hafizuddinus/Tx-and-Rx-Board-W-Estop/README.md

link schematic and layout of tx and rx board:
- tx schematic    : https://kicanvas.org/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
- rx layout       : https://kicanvas.org/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
- rx schematic    : https://kicanvas.org/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
- rx layout       : https://kicanvas.org/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
