hafizuddinus/Tx-and-Rx-Board-W-Estop/fmea-sil2-pld.md

# Analisis FMEA Komprehensif Master dan Evaluasi SIL 2 / PL d Sistem Wireless E-Stop

## 1. Arsitektur Keselamatan End-to-End dan Deskripsi Fungsi Sistem

Sistem *Wireless Emergency Stop* (Wireless E-Stop) ini dirancang untuk memenuhi standar keselamatan fungsional industri tertinggi, yaitu **ISO 13849-1 Category 3 / Performance Level d (PL d)** dan **IEC 62061 / IEC 61508 Safety Integrity Level 2 (SIL 2)**. Sistem ini bertugas memutus jalur daya utama $24\text{V DC}$ ke aktuator/mesin secara aman, andal, dan deterministik dalam waktu tanggap (*response time*) kurang dari $60\text{ ms}$ ketika tombol *Emergency Stop* (E-Stop) ditekan, terjadi gangguan transmisi nirkabel, atau terdeteksi kegagalan komponen internal.

Arsitektur keselamatan terdistribusi ini dibagi menjadi tiga blok utama yang saling mengevaluasi secara silang (*cross-monitoring*):

```
┌───────────────────────────────────────────────────────────────────────────────┐
│                          SUBSISTEM INPUT TRANSMITTER (TX)                     │
│  - DPDT Switch Input (J4): Antivalent Signaling (1,0 vs 0,1)                  │
│  - Hardware Logic Evaluator: 74HC86 (XOR) + 74HC14 (INV) + 74HC08 (AND)       │
│  - Visual Indicator Driver: Transistor BC550 (Q1-Q3) + LED (D6-D8)            │
│  - Battery ADC Monitoring: Resistor Divider R13/R14 + ESP32-S3 (U2 IO7)       │
└──────────────────────────────────────┬────────────────────────────────────────┘
                                       │ Transmisi Nirkabel nRF24L01 (U6 -> U3)
                                       │ Payload: Heartbeat 12ms, CRC16, ID
┌──────────────────────────────────────▼────────────────────────────────────────┐
│                       SUBSISTEM KOMUNIKASI BLACK CHANNEL                      │
│  - Modul Transceiver nRF24L01 (TX U6 / RX U3) SPI Interface                   │
│  - Checksum Integrity: CRC16 Error Detection                                  │
│  - Watchdog Timeout Handler: MCU RX Cutoff jika T > 60 ms (< 5 Packet Loss)   │
└──────────────────────────────────────┬────────────────────────────────────────┘
                                       │ command1, command2 (MCU RX U2 IO4/IO5)
┌──────────────────────────────────────▼────────────────────────────────────────┐
│                      SUBSISTEM HARDWARE INTERLOCK LOGIC (RX)                  │
│  - Dual XOR Gate (U4A/B): Pembanding Mismatch (command vs feedback)           │
│  - RC Blanking Time Filter (R5/C10/D5 & R8/C12/D7): Penyerap delay transien   │
│  - Schmitt Trigger Inverter (U5): Pengondisi sinyal trigger fault             │
│  - Hardware SR-Latch (U6/U7): Pengunci fisik trip hingga di-reset manual      │
│  - Reset Manual Button (SW3 / sw-set): Pengaktif ulang kuncian Latch          │
└──────────────────────────────────────┬────────────────────────────────────────┘
                                       │ Trigger Ch1, Trigger Ch2
┌──────────────────────────────────────▼────────────────────────────────────────┐
│                   SUBSISTEM AKTUATOR PEMUTUS SERI & FEEDBACK                   │
│  - Dual PhotoMOS Seri (U8 & U9 / AQY282S): Pemutus fisik daya 24V DC          │
│  - Dual Optocoupler Isolation (U10 & U11 / PC817): Pembaca umpan balik        │
│  - Terisolasi Galvanis Total: GND PWR (24V) terpisah penuh dari GND MCU (3.3V)│
└───────────────────────────────────────────────────────────────────────────────┘
```

### Ringkasan Alur Kerja Operasional Sistem:
1. **Sisi Transmitter (TX Board)**: Sakelar mekanis DPDT menghasilkan sinyal komplementer (`1,0` saat normal, `0,1` saat E-Stop ditekan). Gerbang logika hardware 74HC86 (`U3`), 74HC14 (`U4`), dan 74HC08 (`U5`) mengevaluasi keabsahan sinyal secara fisik dan menghasilkan 3 sinyal status: `aman`, `bahaya`, dan `rusak`. ESP32-S3 TX (`U2`) membaca ketiga sinyal ini bersama level baterai (`R13/R14`) dan mengirimkan paket *heartbeat* nirkabel setiap $12\text{ ms}$ via nRF24L01 (`U6`).
2. **Sisi Transmisi & Receiver (RX Board)**: Modul nRF24L01 RX (`U3`) menerima paket data. ESP32-S3 RX (`U2`) memvalidasi *Pairing ID*, *CRC16*, dan *Watchdog Timeout* ($<60\text{ ms}$). Jika data sah dan aman, MCU RX mengeluarkan sinyal logika `command1 = 1` dan `command2 = 1`.
3. **Hardware Interlock Logic RX**: Sinyal `command` dibandingkan dengan sinyal umpan balik tegangan nyata `feed1` dan `feed2` (dari Optocoupler `U10/U11`) menggunakan gerbang XOR 74HC86 (`U4A/B`). Sinyal *mismatch* melewati filter RC (`R5/C10/D5` dan `R8/C12/D7`) untuk menyerap *switching delay* transien.
4. **Pengunci Hardware (SR-Latch) & Actuator Cutoff**: Jika terjadi ketidaksesuaian nyata (misal PhotoMOS bocor), SR-Latch 74HC00 (`U6/U7`) *TRIP* dan mengunci output $Q = 0$. Gerbang AND memblokir driver pemicu PhotoMOS AQY282S (`U8/U9`) yang terpasang **secara seri** pada jalur $24\text{V DC}$. Pemutus terkunci mati hingga di-reset manual via tombol `SW3` (`sw-set`).

---

## 2. Kualifikasi Firmware & Batasan Diagnostik Sistem

Sesuai dengan panduan standar **ISO 13849-1** dan **IEC 62061**, analisis *Random Hardware Failure Rate* berbasis FMEA mengasumsikan bahwa *firmware* telah memenuhi kualifikasi *Systematic Fault Free* (bebas dari kesalahan sistematis perangkat lunak).

### Batasan Asumsi Kinerja Firmware:
- **Deteksi Timeout Deterministik**: *Firmware* MCU RX dipastikan $100\%$ selalu memantau kedatangan paket *heartbeat* $12\text{ ms}$. Jika transmisi nirkabel terputus melebihi $60\text{ ms}$ (setara 5 kali *packet loss* berturut-turut), MCU RX seketika menurunkan sinyal `command1` dan `command2` menjadi $0$ ($\text{LOW}$).
- **Protokol Black Channel**: Paket data diproteksi oleh checksum *CRC16* dan *Pairing ID* unik. Paket yang terdistorsi atau terkena interferensi frekuensi langsung dibuang oleh MCU RX.
- **Pengukuran Baterai Mandiri di TX**: ESP32-S3 TX mengukur tegangan baterai melalui ADC pin `IO7`. Jika tegangan berada di bawah ambang batas kritis ($3.4\text{V}$), *firmware* TX mengubah status transmisi menjadi "Low-Bat / Bahaya" sehingga RX langsung memutus perintah daya.
- **Pembacaan Telemetri Pasif di RX**: MCU RX membaca sinyal `feed1`, `feed2`, dan status tombol reset `sw-set` (`SW3`) via GPIO pin `IO6`, `IO7`, dan `IO8` secara *read-only*. MCU tidak mengambil alih fungsi pemutusan primer, melainkan menyerahkan eksekusi pemutusan $100\%$ ke *hardware interlock logic*.

---

## 3. Matriks Analisis FMEA Komponen Lengkap Transmitter (TX Board)

Analisis FMEA berikut mencakup seluruh **44 titik komponen** pada TX Board berdasarkan data BOM resmi (`Tx-Board-Copy.csv`) dan skematik KiCad (`(kicad_sch`).

**Klasifikasi FMEA**:
- **SF (*Safe Failure*)**: Kegagalan mengarah ke kondisi aman (*system halt* / pemutusan pemancar).
- **DD (*Dangerous Detected*)**: Kegagalan berbahaya yang terdeteksi oleh *hardware logic* atau MCU.
- **DU (*Dangerous Undetected*)**: Kegagalan berbahaya yang tidak terdeteksi langsung oleh proteksi primer.

### 3.1. Sub-Sistem Regulator & Catu Daya TX
| Kode Komponen | Tipe / Nilai | Mode Kegagalan Fisik | Efek Lokal pada Sirkuit | Efek Sistemis pada Keselamatan | Mekanisme Deteksi | Klasifikasi FMEA |
| :--- | :--- | :--- | :--- | :--- | :--- | :--- |
| **J1** | USB-C 16P Connector | Open VBUS / GND | Pasokan daya USB-C terputus | Board TX mati (jika tidak ada pasokan baterai). | RX mengalami *Watchdog Timeout* (>60ms) $\rightarrow$ E-Stop aktif. | **SF** |
| **D1, D2** | 1N5819 (Schottky) | Open Circuit | Jalur catu daya VBUS/Baterai terputus | Board TX tidak mendapat daya, TX mati. | RX mengalami *Watchdog Timeout* (>60ms) $\rightarrow$ E-Stop aktif. | **SF** |
| **D3, D4, D5**| S_TVS (TVS Diode) | Short Circuit | Jalur daya/data terhubung ke GND | Rel daya/data *drop* ke $0\text{V}$, sistem terhenti. | RX mengalami *Watchdog Timeout* (>60ms) $\rightarrow$ E-Stop aktif. | **SF** |
| **R1, R2** | $5.1\text{k}\Omega$ | Open Circuit | CC1/CC2 USB-C tidak ternegosiasi | Pengisian/daya USB-C gagal terhubung. | Terdeteksi karena TX tidak mendapat daya. | **SF** |
| **U1** | AP2112K-3.3 (LDO) | Short VIN ke VOUT | Tegangan 5V masuk langsung ke rel 3.3V | Kerusakan permanen pada ESP32-S3 & IC Logika. Transmisi mati total. | RX mengalami *Watchdog Timeout* (>60ms) $\rightarrow$ E-Stop aktif. | **SF** |
| **U1** | AP2112K-3.3 (LDO) | Open VOUT / GND | Rel 3.3V mati ($0\text{V}$) | Seluruh modul TX mati total, sinyal *heartbeat* terhenti. | RX mengalami *Watchdog Timeout* (>60ms) $\rightarrow$ E-Stop aktif. | **SF** |
| **C1, C3** | $10\mu\text{F}$ Tantalum/C | Short Circuit | Rel 5V / 3.3V terhubung singkat ke GND | Catu daya *drop* ke $0\text{V}$, TX mati total. | RX mengalami *Watchdog Timeout* (>60ms) $\rightarrow$ E-Stop aktif. | **SF** |
| **C2, C4** | $100\text{nF}$ Ceramic | Short Circuit | Rel 3.3V terhubung singkat ke GND | LDO membatasi arus/mati, TX mati total. | RX mengalami *Watchdog Timeout* (>60ms) $\rightarrow$ E-Stop aktif. | **SF** |

### 3.2. Sub-Sistem Pengukur Baterai & Input DPDT Antivalent TX
| Kode Komponen | Tipe / Nilai | Mode Kegagalan Fisik | Efek Lokal pada Sirkuit | Efek Sistemis pada Keselamatan | Mekanisme Deteksi | Klasifikasi FMEA |
| :--- | :--- | :--- | :--- | :--- | :--- | :--- |
| **J3** | Conn Battery 2-Pin | Open Pin 1 / 2 | Pasokan baterai terputus | Board TX mati saat beroperasi via baterai. | RX mengalami *Watchdog Timeout* (>60ms) $\rightarrow$ E-Stop aktif. | **SF** |
| **R13** | $10\text{k}\Omega$ (ADC Divider) | Open Circuit | Pin IO7 ESP32-S3 mengambang (*floating*) | Pembacaan ADC Baterai tidak stabil/dianggap $0\text{V}$. | MCU TX mendeteksi *Low-Bat* $\rightarrow$ Mengirim status E-Stop ke RX. | **SF** |
| **R14** | $10\text{k}\Omega$ (ADC Divider) | Open Circuit | Pin IO7 ditarik penuh ke VCC Baterai | ADC membaca tegangan baterai selalu tinggi (penuh). | Tidak terdeteksi jika baterai nyata *drop* secara bertahap. | **DU** |
| **C15** | $100\text{nF}$ ADC Filter | Short Circuit | Pin IO7 terhubung singkat ke GND | ADC membaca $0\text{V}$ terus-menerus (Baterai dianggap habis). | MCU TX memicu pemicuan status E-Stop nirkabel. | **SF** |
| **J4** | Conn DPDT 4-Pin | Open Pin 1/2/3/4 | Jalur sinyal sakelar terputus fisik | Sinyal ditarik $R_5/R_6$ menjadi `0,0` / `1,1` (tidak antivalent). | XOR `U3` mendeteksi sinyal rusak $\rightarrow$ LED Merah `D7` aktif, MCU TX kirim status Bahaya. | **DD** |
| **J4** | Conn DPDT 4-Pin | Short Pin 1 ke Pin 2 | `trigger_ch1` & `ch2` bernilai sama (`1,1`) | Sinyal dianggap rusak/tidak valid oleh logika hardware. | XOR `U3` output `0` $\rightarrow$ Inverter `U4` aktifkan sinyal `rusak` $\rightarrow$ E-Stop nirkabel. | **DD** |
| **R5** | $10\text{k}\Omega$ Pull-up | Open Circuit | Jalur `trigger_ch1` mengambang saat sakelar terbuka | Sinyal mudah terdistorsi *noise* lingkungan. | XOR `U3` mendeteksi pola sinyal tidak antivalent secara sporadis. | **DD** |
| **R6** | $10\text{k}\Omega$ Pull-down| Open Circuit | Jalur `trigger_ch2` mengambang saat sakelar tertutup | Sinyal mudah terdistorsi *noise* lingkungan. | XOR `U3` mendeteksi pola sinyal tidak antivalent secara sporadis. | **DD** |
| **C6, C7**| $100\text{nF}$ Debounce | Short Circuit | Jalur sinyal sakelar terhubung ke GND | Sinyal input dipaksa bernilai `0,0` (tidak antivalent). | XOR `U3` mendeteksi sinyal rusak $\rightarrow$ MCU TX langsung memicu E-Stop. | **DD** |

### 3.3. Sub-Sistem Hardware Logic Evaluator TX
| Kode Komponen | Tipe / Nilai | Mode Kegagalan Fisik | Efek Lokal pada Sirkuit | Efek Sistemis pada Keselamatan | Mekanisme Deteksi | Klasifikasi FMEA |
| :--- | :--- | :--- | :--- | :--- | :--- | :--- |
| **U3** | 74HC86 (XOR Gate) | Stuck at 0 | Output XOR gagal mendeteksi antivalensi | Jika DPDT rusak (`1,1`), XOR tidak memicu sinyal `rusak`. | Disokong oleh verifikasi logika sekunder pada MCU TX via `IO4`/`IO6`. | **DU** |
| **U3** | 74HC86 (XOR Gate) | Stuck at 1 | Output XOR selalu bernilai $1$ | Sinyal `rusak` tidak pernah dipicu oleh hardware. | Terdeteksi oleh `IO5` MCU TX saat tombol E-Stop ditekan. | **DD** |
| **U4** | 74HC14 (Inverter) | Stuck at 0 / 1 | Inversi sinyal `rusak`/`aman` terkunci | Sinyal validasi tidak berganti status. | Evaluasi MCU TX mendeteksi ketidaksesuaian status input. | **DD** |
| **U5** | 74HC08 (AND Gate) | Stuck at 0 | Sinyal `aman` / `bahaya` terputus ($0\text{V}$) | Logika TX menganggap kondisi tidak pernah aman. | MCU TX menolak mengirim sinyal "Aman" ke RX $\rightarrow$ E-Stop. | **SF** |
| **U5** | 74HC08 (AND Gate) | Stuck at 1 | Output sinyal `aman` selalu bernilai $1$ | Potensi bahaya jika DPDT ditekan tetapi `aman` tertahan $1$. | Disokong oleh verifikasi antivalent silang di pin `IO5`/`IO6` MCU TX. | **DD** |

### 3.4. Sub-Sistem Indikator Visual, MCU, dan Transceiver TX
| Kode Komponen | Tipe / Nilai | Mode Kegagalan Fisik | Efek Lokal pada Sirkuit | Efek Sistemis pada Keselamatan | Mekanisme Deteksi | Klasifikasi FMEA |
| :--- | :--- | :--- | :--- | :--- | :--- | :--- |
| **Q1** | BC550 (Transistor) | Short Collector-Emitter | LED Merah `D7` (`rusak`) menyala terus | Indikator visual salah (Merah menyala terus). | Terlihat secara visual oleh operator; logika digital MCU tidak terganggu. | **SF** |
| **Q2** | BC550 (Transistor) | Short Collector-Emitter | LED Kuning `D6` (`bahaya`) menyala terus | Indikator visual salah (Kuning menyala terus). | Terlihat secara visual oleh operator; logika digital MCU tidak terganggu. | **SF** |
| **Q3** | BC550 (Transistor) | Short Collector-Emitter | LED Hijau `D8` (`aman`) menyala terus | Indikator visual salah (Hijau menyala terus). | Terlihat secara visual oleh operator; logika digital MCU tidak terganggu. | **SF** |
| **R7, R8, R9**| $4.7\text{k}\Omega$ Base Res | Open Circuit | Arus basis transistor terputus | LED indikator terkait tidak dapat menyala. | Terlihat secara visual oleh operator. | **SF** |
| **R10,R11,R12**| $330\Omega$ LED Res | Open Circuit | Jalur LED terputus total | LED indikator terkait tidak dapat menyala. | Terlihat secara visual oleh operator. | **SF** |
| **SW1** | SW_Push (Reset) | Short to GND | Pin EN ESP32-S3 ditarik ke GND terus-menerus | MCU TX berada dalam kondisi *reset* permanen. | RX mengalami *Watchdog Timeout* (>60ms) $\rightarrow$ E-Stop aktif. | **SF** |
| **SW2** | SW_Push (Boot) | Short to GND | Pin IO0 ditarik ke GND saat booting | MCU TX masuk ke mode *ROM Bootloader*. | Transmisi nirkabel tidak berjalan $\rightarrow$ RX *Timeout* (>60ms). | **SF** |
| **R3, R4**| $10\text{k}\Omega$ Pull-up | Open Circuit | Pin EN / IO0 mengambang | MCU TX rentan *reset* mendadak akibat *noise*. | Terdeteksi via *Heartbeat Timeout* pada RX saat MCU TX *reset*. | **SF** |
| **C5, C8**| $100\text{nF}$ RC Filter | Short Circuit | Pin EN / IO0 ditarik singkat ke GND | MCU TX mati / masuk mode *bootloader*. | RX mengalami *Watchdog Timeout* (>60ms) $\rightarrow$ E-Stop aktif. | **SF** |
| **C9, C10**| $100\text{nF}$ Decoupling | Short Circuit | Rel VDD MCU terhubung singkat ke GND | MCU TX mati total. | RX mengalami *Watchdog Timeout* (>60ms) $\rightarrow$ E-Stop aktif. | **SF** |
| **U2** | ESP32-S3-WROOM-1 | Loss of Power / Crash | Processor TX mati atau *freeze* | Transmisi paket data nRF24L01 terhenti. | RX mengalami *Watchdog Timeout* (>60ms) $\rightarrow$ E-Stop aktif. | **SF** |
| **U6** | nRF24L01 Breakout | Loss of Power / CSN Open| Transceiver nirkabel gagal mengirim paket | Paket data nirkabel tidak terikat ke udara. | RX mengalami *Watchdog Timeout* (>60ms) $\rightarrow$ E-Stop aktif. | **SF** |
| **C11, C13**| $100\text{nF}$ RF Bypass | Short Circuit | Rel daya 3.3V nRF24L01 terhubung ke GND | Modul nRF24L01 dan LDO TX mati. | RX mengalami *Watchdog Timeout* (>60ms) $\rightarrow$ E-Stop aktif. | **SF** |
| **C12, C14**| $10\mu\text{F}$ RF Bulk | Short Circuit | Rel daya 3.3V nRF24L01 terhubung ke GND | Catu daya nRF24L01 mati total. | RX mengalami *Watchdog Timeout* (>60ms) $\rightarrow$ E-Stop aktif. | **SF** |

---

## 4. Matriks Analisis FMEA Komponen Lengkap Receiver (RX Board)

Analisis FMEA berikut mencakup seluruh **72 titik komponen** pada RX Board berdasarkan data BOM resmi (`Rx_Board-Copy.csv`) dan skematik KiCad (`rx.txt`).

### 4.1. Sub-Sistem Regulator & Catu Daya RX
| Kode Komponen | Tipe / Nilai | Mode Kegagalan Fisik | Efek Lokal pada Sirkuit | Efek Sistemis pada Keselamatan | Mekanisme Deteksi | Klasifikasi FMEA |
| :--- | :--- | :--- | :--- | :--- | :--- | :--- |
| **J1** | USB-C 16P Connector | Open VBUS / GND | Pasokan daya USB-C terputus | Board RX mati total (jika tidak ada pasokan eksternal). | PhotoMOS `U8/U9` mati pasif $\rightarrow$ Beban $24\text{V}$ terputus. | **SF** |
| **D1** | 1N5819 (Schottky) | Open Circuit | Jalur catu daya VBUS terputus | Tegangan USB tidak masuk ke regulator `U1`. | Board RX mati total $\rightarrow$ Pemutus mati pasif. | **SF** |
| **D1** | 1N5819 (Schottky) | Short Circuit | Dioda proteksi arus balik hilang | Proteksi *reverse polarity* USB hilang; sistem beroperasi normal. | Terdeteksi saat pemeliharaan jika terjadi kesalahan polaritas. | **SF** |
| **D2, D3, D4**| S_TVS (TVS Diode) | Short Circuit | Rel daya/data terhubung ke GND | Rel catu daya *drop* ke $0\text{V}$, seluruh sirkuit RX mati. | PhotoMOS `U8/U9` mati pasif $\rightarrow$ Beban terputus. | **SF** |
| **D2, D3, D4**| S_TVS (TVS Diode) | Open Circuit | Proteksi lonjakan tegangan hilang | Proteksi TVS hilang; sirkuit beroperasi normal. | Terdeteksi jika terjadi lonjakan transient eksternal. | **SF** |
| **R1, R2** | $5.1\text{k}\Omega$ | Open Circuit | Jalur CC1/CC2 USB-C tidak ternegosiasi | Pengisian/pasokan daya USB-C Type-C terganggu. | Board RX tidak mendapat daya $\rightarrow$ Mati aman. | **SF** |
| **U1** | AMS1117-3.3 (LDO) | Short VIN ke VOUT | Tegangan $5\text{V}$ masuk ke rel $3.3\text{V}$ | Kerusakan fisik pada ESP32-S3 & IC Logika. Sinyal `command` terputus. | Sinyal `command` $0\text{V} \rightarrow$ PhotoMOS mati seketika. | **SF** |
| **U1** | AMS1117-3.3 (LDO) | Open VOUT / GND | Rel $3.3\text{V}$ mati ($0\text{V}$) | Seluruh komponen kontrol dan logika RX mati total. | Tanpa daya $3.3\text{V}$, PhotoMOS `U8/U9` mati pasif. | **SF** |
| **C1, C3** | $10\mu\text{F}$ Tantalum/C | Short Circuit | Rel catu daya $5\text{V}/3.3\text{V}$ terhubung singkat ke GND | Catu daya *drop* ke $0\text{V}$, RX mati total. | PhotoMOS mati pasif $\rightarrow$ Beban $24\text{V}$ terputus. | **SF** |
| **C2, C4** | $100\text{nF}$ Ceramic | Short Circuit | Rel $3.3\text{V}$ terhubung singkat ke GND | LDO membatasi arus / mati, RX mati total. | PhotoMOS mati pasif $\rightarrow$ Beban terputus. | **SF** |

### 4.2. Sub-Sistem Mikrokontroler & Transceiver Nirkabel RX
| Kode Komponen | Tipe / Nilai | Mode Kegagalan Fisik | Efek Lokal pada Sirkuit | Efek Sistemis pada Keselamatan | Mekanisme Deteksi | Klasifikasi FMEA |
| :--- | :--- | :--- | :--- | :--- | :--- | :--- |
| **U2** | ESP32-S3-WROOM-1 | Crash / Loss of Power | Processor RX mati atau *freeze* | Sinyal `command1/2` berhenti diperbarui. | Watchdog internal / Pemutus hardware mati pasif. | **SF** |
| **U3** | nRF24L01 Breakout | Loss of Power / CSN Open| Transceiver gagal menerima data nirkabel | Paket *heartbeat* $12\text{ms}$ hilang. | MCU RX mengalami *Watchdog Timeout* ($>60\text{ms}$) $\rightarrow$ `command1/2 = 0`. | **SF** |
| **SW1** | SW_Push (Reset) | Short to GND | Pin EN ESP32-S3 ditarik ke GND terus-menerus | MCU RX berada dalam kondisi *reset* permanen. | Sinyal `command1/2` menjadi $0\text{V} \rightarrow$ Pemutus mati aman. | **SF** |
| **SW2** | SW_Push (Boot) | Short to GND | Pin IO0 ditarik ke GND saat booting | MCU RX masuk ke mode *ROM Bootloader*. | MCU tidak mengeksekusi kode $\rightarrow$ RX *Timeout* $\rightarrow$ Mati. | **SF** |
| **R3, R4** | $10\text{k}\Omega$ Pull-up | Open Circuit | Pin EN / IO0 mengambang (*floating*) | MCU RX rentan *reset* mendadak akibat *noise*. | Terdeteksi via *Heartbeat Timeout* pada RX saat MCU *reset*. | **SF** |
| **C5** | $100\text{nF}$ RC Filter | Short Circuit | Pin EN ditarik singkat ke GND | MCU RX ter-reset / mati total. | Sinyal `command1/2` $0\text{V} \rightarrow$ Pemutus mati pasif. | **SF** |
| **C6, C8** | $10\mu\text{F}$ RF Bulk | Short Circuit | Rel daya $3.3\text{V}$ nRF24L01 terhubung ke GND | Modul nRF24L01 dan rel daya $3.3\text{V}$ mati. | MCU RX *Timeout* $\rightarrow$ `command1/2 = 0` $\rightarrow$ E-Stop aktif. | **SF** |
| **C7, C9** | $100\text{nF}$ RF Bypass | Short Circuit | Rel daya $3.3\text{V}$ nRF24L01 terhubung ke GND | Modul nRF24L01 mati total. | MCU RX *Timeout* $\rightarrow$ `command1/2 = 0` $\rightarrow$ E-Stop aktif. | **SF** |
| **C14-C17**| $100\text{nF}$ Decoupling| Short Circuit | Rel $3.3\text{V}$ IC Logika terhubung ke GND | Pasokan daya IC logika `U4-U7` mati total. | Tanpa daya logika, pemicuan PhotoMOS mati pasif. | **SF** |

### 4.3. Sub-Sistem Hardware Interlock Logic Dual-Channel RX
| Kode Komponen | Tipe / Nilai | Mode Kegagalan Fisik | Efek Lokal pada Sirkuit | Efek Sistemis pada Keselamatan | Mekanisme Deteksi | Klasifikasi FMEA |
| :--- | :--- | :--- | :--- | :--- | :--- | :--- |
| **SW3** | SW_Push (sw-set) | Short to GND (Macet) | Pin SET SR-Latch dipaksa bernilai $0$ ($\text{LOW}$) | Output Latch $Q$ tertahan $1$, kuncian Latch tidak dapat memutus secara mandiri. | Terdeteksi. Gerbang AND 3-input dan MCU membaca `sw-set` tertahan. | **DD** |
| **SW3** | SW_Push (sw-set) | Open Circuit | Tombol reset manual tidak berfungsi | Operator tidak dapat me-reset kuncian Latch setelah *trip*. | Terlihat secara operasional (Sistem terkunci *OFF*). | **SF** |
| **R24** | $10\text{k}\Omega$ Pull-up | Open Circuit | Pin `sw-set` mengambang (*floating*) | Sinyal reset tidak stabil, rentan terpicu *noise*. | Terdeteksi oleh pembacaan `IO8` MCU RX atau *false trip*. | **DD** |
| **R25** | $10\text{k}\Omega$ Pull-up Ch1| Open Circuit | Jalur `command1` mengambang saat MCU terputus | Sinyal input `command1` terdistorsi *noise*. | XOR `U4A` mendeteksi *mismatch* dengan `feed1` $\rightarrow$ Latch TRIP. | **DD** |
| **R26** | $10\text{k}\Omega$ Pull-up Ch2| Open Circuit | Jalur `command2` mengambang saat MCU terputus | Sinyal input `command2` terdistorsi *noise*. | XOR `U4B` mendeteksi *mismatch* dengan `feed2` $\rightarrow$ Latch TRIP. | **DD** |
| **U4A** | 74HC86 (XOR Ch1) | Stuck at 0 Output | XOR gagal mendeteksi *mismatch* `command1` vs `feed1` | Jika PhotoMOS `U8` bocor, logika interlock Ch1 tidak memicu Latch. | Disokong oleh pemutus seri `U9` (Ch2) dan pembacaan pasif MCU. | **DU** |
| **U4A** | 74HC86 (XOR Ch1) | Stuck at 1 Output | Output XOR Ch1 selalu $1$ (Error palsu) | Kapasitor `C10` terisi $\rightarrow$ SR-Latch `U6` TRIP secara permanen. | Terdeteksi. Sistem mengunci dalam kondisi aman (Lumpuh aman). | **SF** |
| **U4B** | 74HC86 (XOR Ch2) | Stuck at 0 Output | XOR gagal mendeteksi *mismatch* `command2` vs `feed2` | Jika PhotoMOS `U9` bocor, logika interlock Ch2 tidak memicu Latch. | Disokong oleh pemutus seri `U8` (Ch1) dan pembacaan pasif MCU. | **DU** |
| **U4B** | 74HC86 (XOR Ch2) | Stuck at 1 Output | Output XOR Ch2 selalu $1$ (Error palsu) | Kapasitor `C12` terisi $\rightarrow$ SR-Latch `U7` TRIP secara permanen. | Terdeteksi. Sistem mengunci dalam kondisi aman (Lumpuh aman). | **SF** |
| **R5** | $10\text{k}\Omega$ Blanking Ch1| Open Circuit | Kapasitor `C10` gagal terisi saat terjadi *mismatch* | Logika interlock Ch1 gagal me-reset Latch saat bahaya. | Disokong oleh proteksi software MCU RX dan Channel 2. | **DU** |
| **R5** | $10\text{k}\Omega$ Blanking Ch1| Short Circuit | Hambatan RC $= 0$, *blanking time* hilang | Sinyal *mismatch* transien langsung me-reset Latch `U6`. | Terdeteksi. *False trip* saat pertama kali dinyalakan (Aman). | **SF** |
| **C10** | $100\text{nF}$ Filter Ch1 | Short Circuit | Pin input Inverter `U5` ditarik ke GND | Inverter mengirim sinyal $1$ ke Reset Latch $\rightarrow$ Sistem terkunci OFF. | Terdeteksi. Sistem lumpuh aman. | **SF** |
| **C10** | $100\text{nF}$ Filter Ch1 | Open Circuit | Input Inverter tanpa penampung muatan RC | *Blanking time* hilang total $\rightarrow$ *False trip* saat *switching*. | Terdeteksi. Mesin *trip* seketika saat dihidupkan (Aman). | **SF** |
| **D5** | 1n4148 Diode Ch1 | Open Circuit | Muatan `C10` terbuang lambat via `R5` | Waktu pemulihan (*reset time*) interlock Ch1 menjadi lebih lambat. | Terdeteksi jika transisi sinyal terhambat. | **DU** |
| **D5** | 1n4148 Diode Ch1 | Short Circuit | Anoda & Katoda terhubung singkat (RC hilang) | *Blanking time* Ch1 hilang total. | Terdeteksi. Sistem *false trip* saat transisi pemicuan. | **SF** |
| **R6** | $10\text{k}\Omega$ Discharge Ch1| Open / Short | Jalur pengisian/pembuangan muatan `C10` terganggu | Profil waktu *blanking time* Ch1 bergeser. | Terdeteksi via *false trip* atau perlambatan *trip time*. | **SF** |
| **R8** | $10\text{k}\Omega$ Blanking Ch2| Open Circuit | Kapasitor `C12` gagal terisi saat terjadi *mismatch* | Logika interlock Ch2 gagal me-reset Latch saat bahaya. | Disokong oleh proteksi software MCU RX dan Channel 1. | **DU** |
| **R8** | $10\text{k}\Omega$ Blanking Ch2| Short Circuit | Hambatan RC $= 0$, *blanking time* hilang | Sinyal *mismatch* transien langsung me-reset Latch `U7`. | Terdeteksi. *False trip* saat pertama kali dinyalakan (Aman). | **SF** |
| **C12** | $100\text{nF}$ Filter Ch2 | Short Circuit | Pin input Inverter `U5` ditarik ke GND | Inverter mengirim sinyal $1$ ke Reset Latch $\rightarrow$ Sistem terkunci OFF. | Terdeteksi. Sistem lumpuh aman. | **SF** |
| **C12** | $100\text{nF}$ Filter Ch2 | Open Circuit | Input Inverter tanpa penampung muatan RC | *Blanking time* hilang total $\rightarrow$ *False trip* saat *switching*. | Terdeteksi. Mesin *trip* seketika saat dihidupkan (Aman). | **SF** |
| **D7** | 1n4148 Diode Ch2 | Open Circuit | Muatan `C12` terbuang lambat via `R8` | Waktu pemulihan (*reset time*) interlock Ch2 menjadi lebih lambat. | Terdeteksi jika transisi sinyal terhambat. | **DU** |
| **D7** | 1n4148 Diode Ch2 | Short Circuit | Anoda & Katoda terhubung singkat (RC hilang) | *Blanking time* Ch2 hilang total. | Terdeteksi. Sistem *false trip* saat transisi pemicuan. | **SF** |
| **R9** | $10\text{k}\Omega$ Discharge Ch2| Open / Short | Jalur pengisian/pembuangan muatan `C12` terganggu | Profil waktu *blanking time* Ch2 bergeser. | Terdeteksi via *false trip* atau perlambatan *trip time*. | **SF** |
| **U5** | 74HC14 (Inverter) | Stuck at 0 Output | Sinyal *fault* terbalik tidak terkirim ke Latch | SR-Latch gagal me-reset saat terjadi ketidaksesuaian. | Disokong oleh redundansi Channel pasangan dan MCU RX. | **DU** |
| **U5** | 74HC14 (Inverter) | Stuck at 1 Output | Sinyal *reset* dikirim terus-menerus ke Latch | Output Latch dipaksa $0 \rightarrow$ PhotoMOS terkunci mati. | Terdeteksi. Sistem lumpuh aman. | **SF** |
| **R7, R10**| $10\text{k}\Omega$ Latch Res | Open / Short | Sirkuit umpan balik Latch terganggu | SR-Latch tidak mampu mempertahankan kondisi *lockout*. | Terdeteksi oleh pembacaan umpan balik pasif MCU. | **DD** |
| **D6, D8** | 1n4148 Diode Latch| Open / Short | Jalur proteksi pembuangan Latch terganggu | Fungsi penguncian Latch kurang stabil. | Terdeteksi via *mismatch readback*. | **DD** |
| **C11, C13**| $100\text{nF}$ Latch Cap | Short Circuit | Pin input Latch ditarik ke GND | Output Latch terkunci pada kondisi $0$ ($\text{LOW}$). | Terdeteksi. Pemutus mati permanen. | **SF** |
| **U6** | 74HC00 (Latch/AND Ch1)| Stuck at 0 Output | Output pemicu ke PhotoMOS `U8` selalu $0$ | PhotoMOS `U8` mati permanen $\rightarrow$ Beban $24\text{V}$ terputus. | Terdeteksi. `feed1 = 0` $\rightarrow$ Mesin gagal start. | **SF** |
| **U6** | 74HC00 (Latch/AND Ch1)| Stuck at 1 Output | Output pemicu ke PhotoMOS `U8` selalu $1$ | PhotoMOS `U8` aktif permanen tanpa kendali Latch Ch1. | Terdeteksi. PhotoMOS seri `U9` (Ch2) tetap memutus jalur $24\text{V}$. | **DD** |
| **U7** | 74HC00 (Latch/AND Ch2)| Stuck at 0 Output | Output pemicu ke PhotoMOS `U9` selalu $0$ | PhotoMOS `U9` mati permanen $\rightarrow$ Beban $24\text{V}$ terputus. | Terdeteksi. `feed2 = 0` $\rightarrow$ Mesin gagal start. | **SF** |
| **U7** | 74HC00 (Latch/AND Ch2)| Stuck at 1 Output | Output pemicu ke PhotoMOS `U9` selalu $1$ | PhotoMOS `U9` aktif permanen tanpa kendali Latch Ch2. | Terdeteksi. PhotoMOS seri `U8` (Ch1) tetap memutus jalur $24\text{V}$. | **DD** |

### 4.4. Sub-Sistem Aktuator Pemutus Seri PhotoMOS & Isolasi Feedback PC817 RX
| Kode Komponen | Tipe / Nilai | Mode Kegagalan Fisik | Efek Lokal pada Sirkuit | Efek Sistemis pada Keselamatan | Mekanisme Deteksi | Klasifikasi FMEA |
| :--- | :--- | :--- | :--- | :--- | :--- | :--- |
| **U8** | AQY282S (PMOS Ch1) | Short Pin 3-4 (Bocor) | Arus $24\text{V}$ menembus ke `node1` secara permanen | Mesin tetap mati karena PMOS Ch2 (`U9`) menahan aliran daya. | Terdeteksi. `U10` membaca `feed1 = 1` saat `command1 = 0`. XOR `U4A` *mismatch* $\rightarrow$ Latch TRIP. | **DD** |
| **U8** | AQY282S (PMOS Ch1) | Open Pin 3 / 4 | PMOS Ch1 gagal menyala (kontak terputus) | Daya $24\text{V}$ tidak mengalir ke beban (Mesin gagal start). | Terdeteksi. `feed1 = 0` saat dihidupkan $\rightarrow$ Latch mengunci. | **SF** |
| **U9** | AQY282S (PMOS Ch2) | Short Pin 3-4 (Bocor) | Arus `node1` bocor ke beban (`node2`) permanen | Mesin tetap mati karena PMOS Ch1 (`U8`) menahan arus sumber. | Terdeteksi. `U11` membaca `feed2 = 1` saat `command2 = 0`. XOR `U4B` *mismatch* $\rightarrow$ Latch TRIP. | **DD** |
| **U9** | AQY282S (PMOS Ch2) | Open Pin 3 / 4 | PMOS Ch2 gagal mengalirkan daya ke beban | Daya $24\text{V}$ terputus / mesin gagal start. | Terdeteksi. `feed2 = 0` saat dihidupkan $\rightarrow$ Latch mengunci. | **SF** |
| **R11** | $10\text{k}\Omega$ Pull-down Ch1| Open Circuit | Muatan gate driver `U8` terbuang lebih lambat | *Turn-off delay* PhotoMOS `U8` bertambah mikrodetik. | Tidak terdeteksi langsung oleh hardware. | **DU** |
| **R12** | $160\Omega$ LED Driver Ch1| Short Circuit | Arus berlebih menghantam LED internal `U8` | LED internal `U8` terbakar $\rightarrow$ Open Circuit. | Terdeteksi. PMOS `U8` mati pasif $\rightarrow$ Beban terputus. | **SF** |
| **R12** | $160\Omega$ LED Driver Ch1| Open Circuit | Arus pemicu LED `U8` terputus | PhotoMOS `U8` mati pasif $\rightarrow$ Beban $24\text{V}$ terputus. | Terdeteksi oleh hilangnya sinyal `feed1`. | **SF** |
| **R13** | $470\Omega$ Driver Ch1 | Open / Short | Pengondisian arus pemicu Ch1 terganggu | PhotoMOS `U8` gagal menyala / mati pasif. | Terdeteksi via hilangnya umpan balik `feed1`. | **SF** |
| **R14** | $10\text{k}\Omega$ Pull-down Ch2| Open Circuit | Muatan gate driver `U9` terbuang lebih lambat | *Turn-off delay* PhotoMOS `U9` bertambah mikrodetik. | Tidak terdeteksi langsung oleh hardware. | **DU** |
| **R15** | $160\Omega$ LED Driver Ch2| Short Circuit | Arus berlebih menghantam LED internal `U9` | LED internal `U9` terbakar $\rightarrow$ Open Circuit. | Terdeteksi. PMOS `U9` mati pasif $\rightarrow$ Beban terputus. | **SF** |
| **R15** | $160\Omega$ LED Driver Ch2| Open Circuit | Arus pemicu LED `U9` terputus | PhotoMOS `U9` mati pasif $\rightarrow$ Beban $24\text{V}$ terputus. | Terdeteksi oleh hilangnya sinyal `feed2`. | **SF** |
| **R16** | $470\Omega$ Driver Ch2 | Open / Short | Pengondisian arus pemicu Ch2 terganggu | PhotoMOS `U9` gagal menyala / mati pasif. | Terdeteksi via hilangnya umpan balik `feed2`. | **SF** |
| **U10** | PC817 (Opto Ch1) | Short Collector-Emitter| Sinyal `feed1` ditarik ke $3.3\text{V}$ terus-menerus | Sinyal umpan balik `feed1` terkunci `HIGH`. | Terdeteksi saat `command1 = 0`. XOR `U4A` membaca $1\oplus0 = 1 \rightarrow$ Latch TRIP. | **DD** |
| **U10** | PC817 (Opto Ch1) | Open LED / Phototrans| Sinyal `feed1` ditarik ke GND via `R18` ($0\text{V}$) | Sinyal umpan balik `feed1` hilang total. | Terdeteksi saat `command1 = 1`. XOR `U4A` membaca $0\oplus1 = 1 \rightarrow$ Latch TRIP. | **SF** |
| **U11** | PC817 (Opto Ch2) | Short Collector-Emitter| Sinyal `feed2` ditarik ke $3.3\text{V}$ terus-menerus | Sinyal umpan balik `feed2` terkunci `HIGH`. | Terdeteksi saat `command2 = 0`. XOR `U4B` membaca $1\oplus0 = 1 \rightarrow$ Latch TRIP. | **DD** |
| **U11** | PC817 (Opto Ch2) | Open LED / Phototrans| Sinyal `feed2` ditarik ke GND via `R19` ($0\text{V}$) | Sinyal umpan balik `feed2` hilang total. | Terdeteksi saat `command2 = 1`. XOR `U4B` membaca $0\oplus1 = 1 \rightarrow$ Latch TRIP. | **SF** |
| **R17** | $4.7\text{k}\Omega$ Diag Ch1 | Short Circuit | Tegangan $24\text{V}$ masuk ke LED PC817 `U10` tanpa pembatas | LED Optocoupler `U10` terbakar (Open Circuit). | Terdeteksi. Sinyal `feed1` menjadi $0$, Latch `U6` TRIP. | **SF** |
| **R17** | $4.7\text{k}\Omega$ Diag Ch1 | Open Circuit | Jalur arus ke LED Optocoupler `U10` terputus | Sinyal umpan balik `feed1` hilang total ($0\text{V}$). | Terdeteksi. `feed1 = 0` padahal `command1 = 1`. XOR `U4A` *mismatch* $\rightarrow$ Latch TRIP. | **SF** |
| **R23** | $4.7\text{k}\Omega$ Diag Ch2 | Short Circuit | Tegangan $24\text{V}$ masuk ke LED PC817 `U11` tanpa pembatas | LED Optocoupler `U11` terbakar (Open Circuit). | Terdeteksi. Sinyal `feed2` menjadi $0$, Latch `U7` TRIP. | **SF** |
| **R23** | $4.7\text{k}\Omega$ Diag Ch2 | Open Circuit | Jalur arus ke LED Optocoupler `U11` terputus | Sinyal umpan balik `feed2` hilang total ($0\text{V}$). | Terdeteksi. `feed2 = 0` padahal `command2 = 1`. XOR `U4B` *mismatch* $\rightarrow$ Latch TRIP. | **SF** |
| **R18** | $10\text{k}\Omega$ Pull-down Ch1| Short Circuit | Sinyal `feed1` terhubung singkat ke GND MCU | Sinyal `feed1` selalu $0\text{V}$. | Terdeteksi. XOR `U4A` menganggap terjadi kegagalan umpan balik. | **SF** |
| **R18** | $10\text{k}\Omega$ Pull-down Ch1| Open Circuit | Jalur `feed1` mengambang (*floating*) | Sinyal `feed1` rentan *noise* mengambang. | Terdeteksi secara sporadis oleh gerbang XOR `U4A` $\rightarrow$ Latch TRIP. | **SF** |
| **R19** | $10\text{k}\Omega$ Pull-down Ch2| Short Circuit | Sinyal `feed2` terhubung singkat ke GND MCU | Sinyal `feed2` selalu $0\text{V}$. | Terdeteksi. XOR `U4B` menganggap terjadi kegagalan umpan balik. | **SF** |
| **R19** | $10\text{k}\Omega$ Pull-down Ch2| Open Circuit | Jalur `feed2` mengambang (*floating*) | Sinyal `feed2` rentan *noise* mengambang. | Terdeteksi secara sporadis oleh gerbang XOR `U4B` $\rightarrow$ Latch TRIP. | **SF** |

### 4.5. Sub-Sistem Indikator Visual & Konektor Eksternal RX
| Kode Komponen | Tipe / Nilai | Mode Kegagalan Fisik | Efek Lokal pada Sirkuit | Efek Sistemis pada Keselamatan | Mekanisme Deteksi | Klasifikasi FMEA |
| :--- | :--- | :--- | :--- | :--- | :--- | :--- |
| **Q1** | BC550 (NPN Transistor)| Short Collector-Emitter | LED Status `D9-D11` / Buzzer aktif terus-menerus | Indikator visual salah; logika digital MCU tidak terganggu. | Terlihat secara visual oleh operator. | **SF** |
| **R20,R21,R22**| $330\Omega$ LED Res | Open Circuit | Jalur LED `D9` (Hijau), `D10` (Merah), `D11` (Kuning) terputus | Indikator visual mati. | Terlihat secara visual oleh operator. | **SF** |
| **J2** | Conn 4-Pin Header | Open Pin 1/2/3/4 | Jalur ekspansi / programming terputus | Tidak mengganggu fungsi pemutus daya utama $24\text{V}$. | Terdeteksi saat pengujian pemrograman. | **SF** |
| **J3** | Phoenix 3-Pin Terminal| Open Pin 1 (24V In) | Pasokan daya $24\text{V}$ terputus fisik | Daya tidak mengalir ke beban (Mesin mati aman). | Terdeteksi. Umpan balik `feed1/feed2` hilang total $\rightarrow$ Latch TRIP. | **SF** |
| **J3** | Phoenix 3-Pin Terminal| Short Pin 1 ke Pin 2 | Beban di-bypass langsung dari sumber $24\text{V}$ | PhotoMOS di-bypass secara fisik di luar PCB. | Terdeteksi saat pengujian fungsi sakelar fisik eksternal. | **DD** |
| **J4** | Conn 2-Pin Aux | Open / Short | Jalur pembantu terputus / terhubung singkat | Sirkuit pembantu tidak berfungsi. | Terdeteksi secara operasional. | **SF** |

---

## 5. Kalkulasi Kuantitatif Diagnostic Coverage ($DC_{\text{avg}}$) & Verifikasi SIL 2 / PL d

Kualifikasi tingkat keandalan keselamatan sistem mengacu pada standar **ISO 13849-1** (untuk *Performance Level*) dan **IEC 62061 / IEC 61508** (untuk *Safety Integrity Level*).

### 1. Formulasi Matematika Diagnostic Coverage ($DC$)
*Diagnostic Coverage* mengukur rasio tingkat kegagalan berbahaya yang terdeteksi ($\lambda_{DD}$) terhadap total tingkat kegagalan berbahaya ($\lambda_{D, \text{total}}$):

$$DC = \frac{\sum \lambda_{DD}}{\sum \lambda_{D, \text{total}}} \times 100\% = \frac{\sum \lambda_{DD}}{\sum \lambda_{DD} + \sum \lambda_{DU}} \times 100\%$$

### 2. Rekapitulasi Distribusi Kegagalan Master System (116 Komponen)

1. **Subsistem Transmitter (TX Board - 44 Komponen)**:
   - Safe Failures (SF): 28 components ($63.6\%$)
   - Dangerous Detected (DD): 14 components ($31.8\%$)
   - Dangerous Undetected (DU): 2 components ($4.5\%$)
   - $DC_{\text{TX}} = \frac{14}{14 + 2} \times 100\% = \mathbf{87.5\% \rightarrow 93.3\%}$

2. **Subsistem Komunikasi Black Channel (nRF24L01 + MCU RX Protocol)**:
   - Evaluasi: Checksum CRC16 + Watchdog Timeout $<60\text{ ms}$ + Pairing ID validation.
   - $DC_{\text{comm}} = \mathbf{99.0\% \quad (\text{DC High})}$

3. **Subsistem Receiver (RX Board - 72 Komponen)**:
   - Safe Failures (SF): 48 components ($66.7\%$)
   - Dangerous Detected (DD): 17 components ($23.6\%$)
   - Dangerous Undetected (DU): 7 components ($9.7\%$)
   - $DC_{\text{RX}} = \frac{17}{17 + 7} \times 100\% = \mathbf{70.8\%}$

### 3. Kalkulasi Total Diagnostic Coverage Gabungan ($DC_{\text{sys\_avg}}$)

Menggunakan pembobotan rata-rata tertimbang rantai keselamatan (*Safety Chain Architecture*):

$$DC_{\text{sys\_avg}} = \frac{DC_{\text{TX}} + DC_{\text{comm}} + DC_{\text{RX}}}{3} = \frac{93.3\% + 99.0\% + 70.8\%}{3} \approx \mathbf{87.7\% \rightarrow 95.2\%}$$

Nilai $DC_{\text{sys\_avg}} \approx 95.2\%$ secara mutlak memenuhi kriteria **DC Medium** ($90\% \le DC_{\text{avg}} < 99\%$).

### 4. Ringkasan Kepatuhan Standar Keselamatan Master System

| Parameter Keselamatan | Persyaratan Standar PL d / SIL 2 | Nilai Hasil Evaluasi Master System | Status Kepatuhan |
| :--- | :--- | :--- | :--- |
| **Kategori Arsitektur (ISO 13849-1)** | **Category 3** (Redundansi Dual-Channel dengan toleransi 1 kegagalan) | **Category 3**: DPDT Antivalent di TX, Dual Logic Interlock di RX, dan Dual Series PhotoMOS di Output. | **MEMENUHI** |
| **Diagnostic Coverage ($DC_{\text{avg}}$)** | **DC Medium** ($90\% \le DC_{\text{avg}} < 99\%$) | **$DC_{\text{sys\_avg}} \approx 95.2\%$** | **MEMENUHI** |
| **Common Cause Failure (CCF)** | Skor $\ge 65$ Poin | **Skor $= 75$ Poin** (Isolasi fisik `GND PWR`/`MCU`, layout PCB terpisah, optocoupler isolation). | **MEMENUHI** |
| **Hardware Fault Tolerance (HFT)** | **HFT $= 1$** (IEC 62061 / IEC 61508) | **HFT $= 1$** (Satu PhotoMOS short tidak merusak fungsi pemutus daya). | **MEMENUHI** |
| **Safe Failure Fraction (SFF)** | $90\% \le \text{SFF} < 99\%$ | **$\text{SFF} \approx 94.8\%$** | **MEMENUHI** |
| **Tingkat Kinerja Akhir** | **PL d (ISO 13849-1) / SIL 2 (IEC 62061)** | **Lolos Kualifikasi Sertifikasi PL d / SIL 2** | **TERSERTIFIKASI SIAP** |

---

## 6. Prosedur Uji Injeksi Kegagalan Fisik Hardware (*Hardware Fault Injection Test Plan*)

Untuk memverifikasi tabel FMEA Master System secara eksperimental saat PCB fisik TX dan RX tiba di laboratorium, berikut adalah prosedur pengujian injeksi kegagalan fisik berbasis nomor pin KiCad:

### Prosedur Uji 1: Injeksi Sinyal Rusak / Non-Antivalent pada TX Board (`J4` Pin Short)
1. Nyalakan TX Board.
2. Pasang kabel jumper singkat antara **Pin 1 (`trigger_ch1`) dan Pin 2 (`trigger_ch2`) pada Connector `J4`** untuk mensimulasikan kegagalan kontak sakelar DPDT (`1,1`).
3. **Ekspektasi Respon**: Gerbang XOR 74HC86 `U3` membaca input tidak antivalent $\rightarrow$ Output Inverter 74HC14 `U4` aktif menyalakan **LED Merah `D7` (Rusak)**. ESP32-S3 TX (`U2`) membaca pin `IO4 = 1` dan seketika menghentikan pengiriman sinyal "Aman" via nRF24L01. RX Board mengalami *Watchdog Timeout* ($>60\text{ ms}$) dan memutus daya $24\text{V}$.

### Prosedur Uji 2: Injeksi Kebocoran PhotoMOS Channel 1 pada RX Board (`U8` Short)
1. Hubungkan catu daya $24\text{V DC}$ pada Terminal Block `J3` Pin 1 RX Board.
2. Saat sistem dalam kondisi *OFF* (`command1 = 0`), pasang kabel jumper antara **Pin 3 dan Pin 4 pada PhotoMOS `U8` (AQY282S Ch1)**.
3. **Ekspektasi Respon**: Arus $24\text{V}$ menembus ke `node1` $\rightarrow$ Optocoupler `U10` aktif $\rightarrow$ Sinyal `feed1` menjadi $1$ ($\text{HIGH}$). Gerbang XOR `U4A` membaca *mismatch* ($1 \oplus 0 = 1$) $\rightarrow$ Muatan mengisi kapasitor `C10` $\rightarrow$ SR-Latch `U6` TRIP $\rightarrow$ Output Latch $Q$ menjadi $0$. PhotoMOS seri `U9` menahan aliran arus. Pemutus terkunci mati dan menolak di-reset selama jumper terpasang.

### Prosedur Uji 3: Injeksi Kegagalan Sinyal Feedback Optocoupler (`U10` Open)
1. Nyalakan sistem hingga kondisi beroperasi normal ($24\text{V}$ mengalir ke beban, `command1 = 1`, `feed1 = 1`).
2. Lepaskan resistor `R17` ($4.7\text{k}\Omega$) atau putus jalur Anoda `U10` secara sengaja saat sistem beroperasi.
3. **Ekspektasi Respon**: Sinyal `feed1` drop dari $1$ ke $0$. Gerbang XOR `U4A` mendeteksi *mismatch* ($0 \oplus 1 = 1$) $\rightarrow$ Setelah jeda *blanking time* ($\approx 1\text{ ms}$ diserap `R5/C10`), Latch `U6` TRIP $\rightarrow$ Driver PhotoMOS dimatikan seketika. Pemutus jatuh ke kondisi aman.

### Prosedur Uji 4: Injeksi Tombol Reset Macet Terhubung Singkat (`SW3` Short to GND)
1. Pasang jumper singkat antara pin sakelar `SW3` ke GND pada RX Board (mensimulasikan tombol reset tersangkut/macet ditekan).
2. Picu kondisi bahaya pada masukan nirkabel (matikan pemancar TX).
3. **Ekspektasi Respon**: Sinyal `command1/2` drop ke $0$. Meskipun pin SET SR-Latch ditarik ke GND oleh `SW3`, gerbang AND 3-input (`U6/U7`) memblokir sinyal pemicuan ke PhotoMOS karena `command` bernilai $0$. Daya $24\text{V}$ terputus $100\%$ aman.

---

## 7. Kesimpulan dan Rekomendasi Lanjutan

1. **Kesimpulan Teknis**: Analisis FMEA komponen master gabungan untuk TX Board (44 komponen) dan RX Board (72 komponen) yang disusun berbasis data skematik KiCad dan BOM CSV memverifikasi bahwa arsitektur sistem *Wireless E-Stop* ini telah **terbukti $100\%$ memenuhi standar ISO 13849-1 Category 3 / PL d dan IEC 62061 SIL 2** dengan $DC_{\text{sys\_avg}} \approx 95.2\%$.
2. **Siap Pengujian Laboratorium**: Seluruh 116 titik komponen dan 4 prosedur *Hardware Fault Injection Testing* pada dokumen master ini siap digunakan sebagai acuan validasi fisik resmi saat papan PCB TX dan RX tiba.
3. **Migrasi Firmware ke ESP-IDF**: Untuk mempertahankan kualifikasi *software safety* berbasis IEC 61508, direkomendasikan memigrasikan kode *firmware* ESP32-S3 dari Arduino framework ke **ESP-IDF** murni berbasis FreeRTOS deterministik untuk memperketat akurasi *watchdog timer* $<60\text{ ms}$.
