hafizuddinus/Tx-and-Rx-Board-W-Estop/Rx_Board-Copy.kicad_pcb

## KiCad design Rx_Board-Copy.kicad_pcb (2026-10-25)

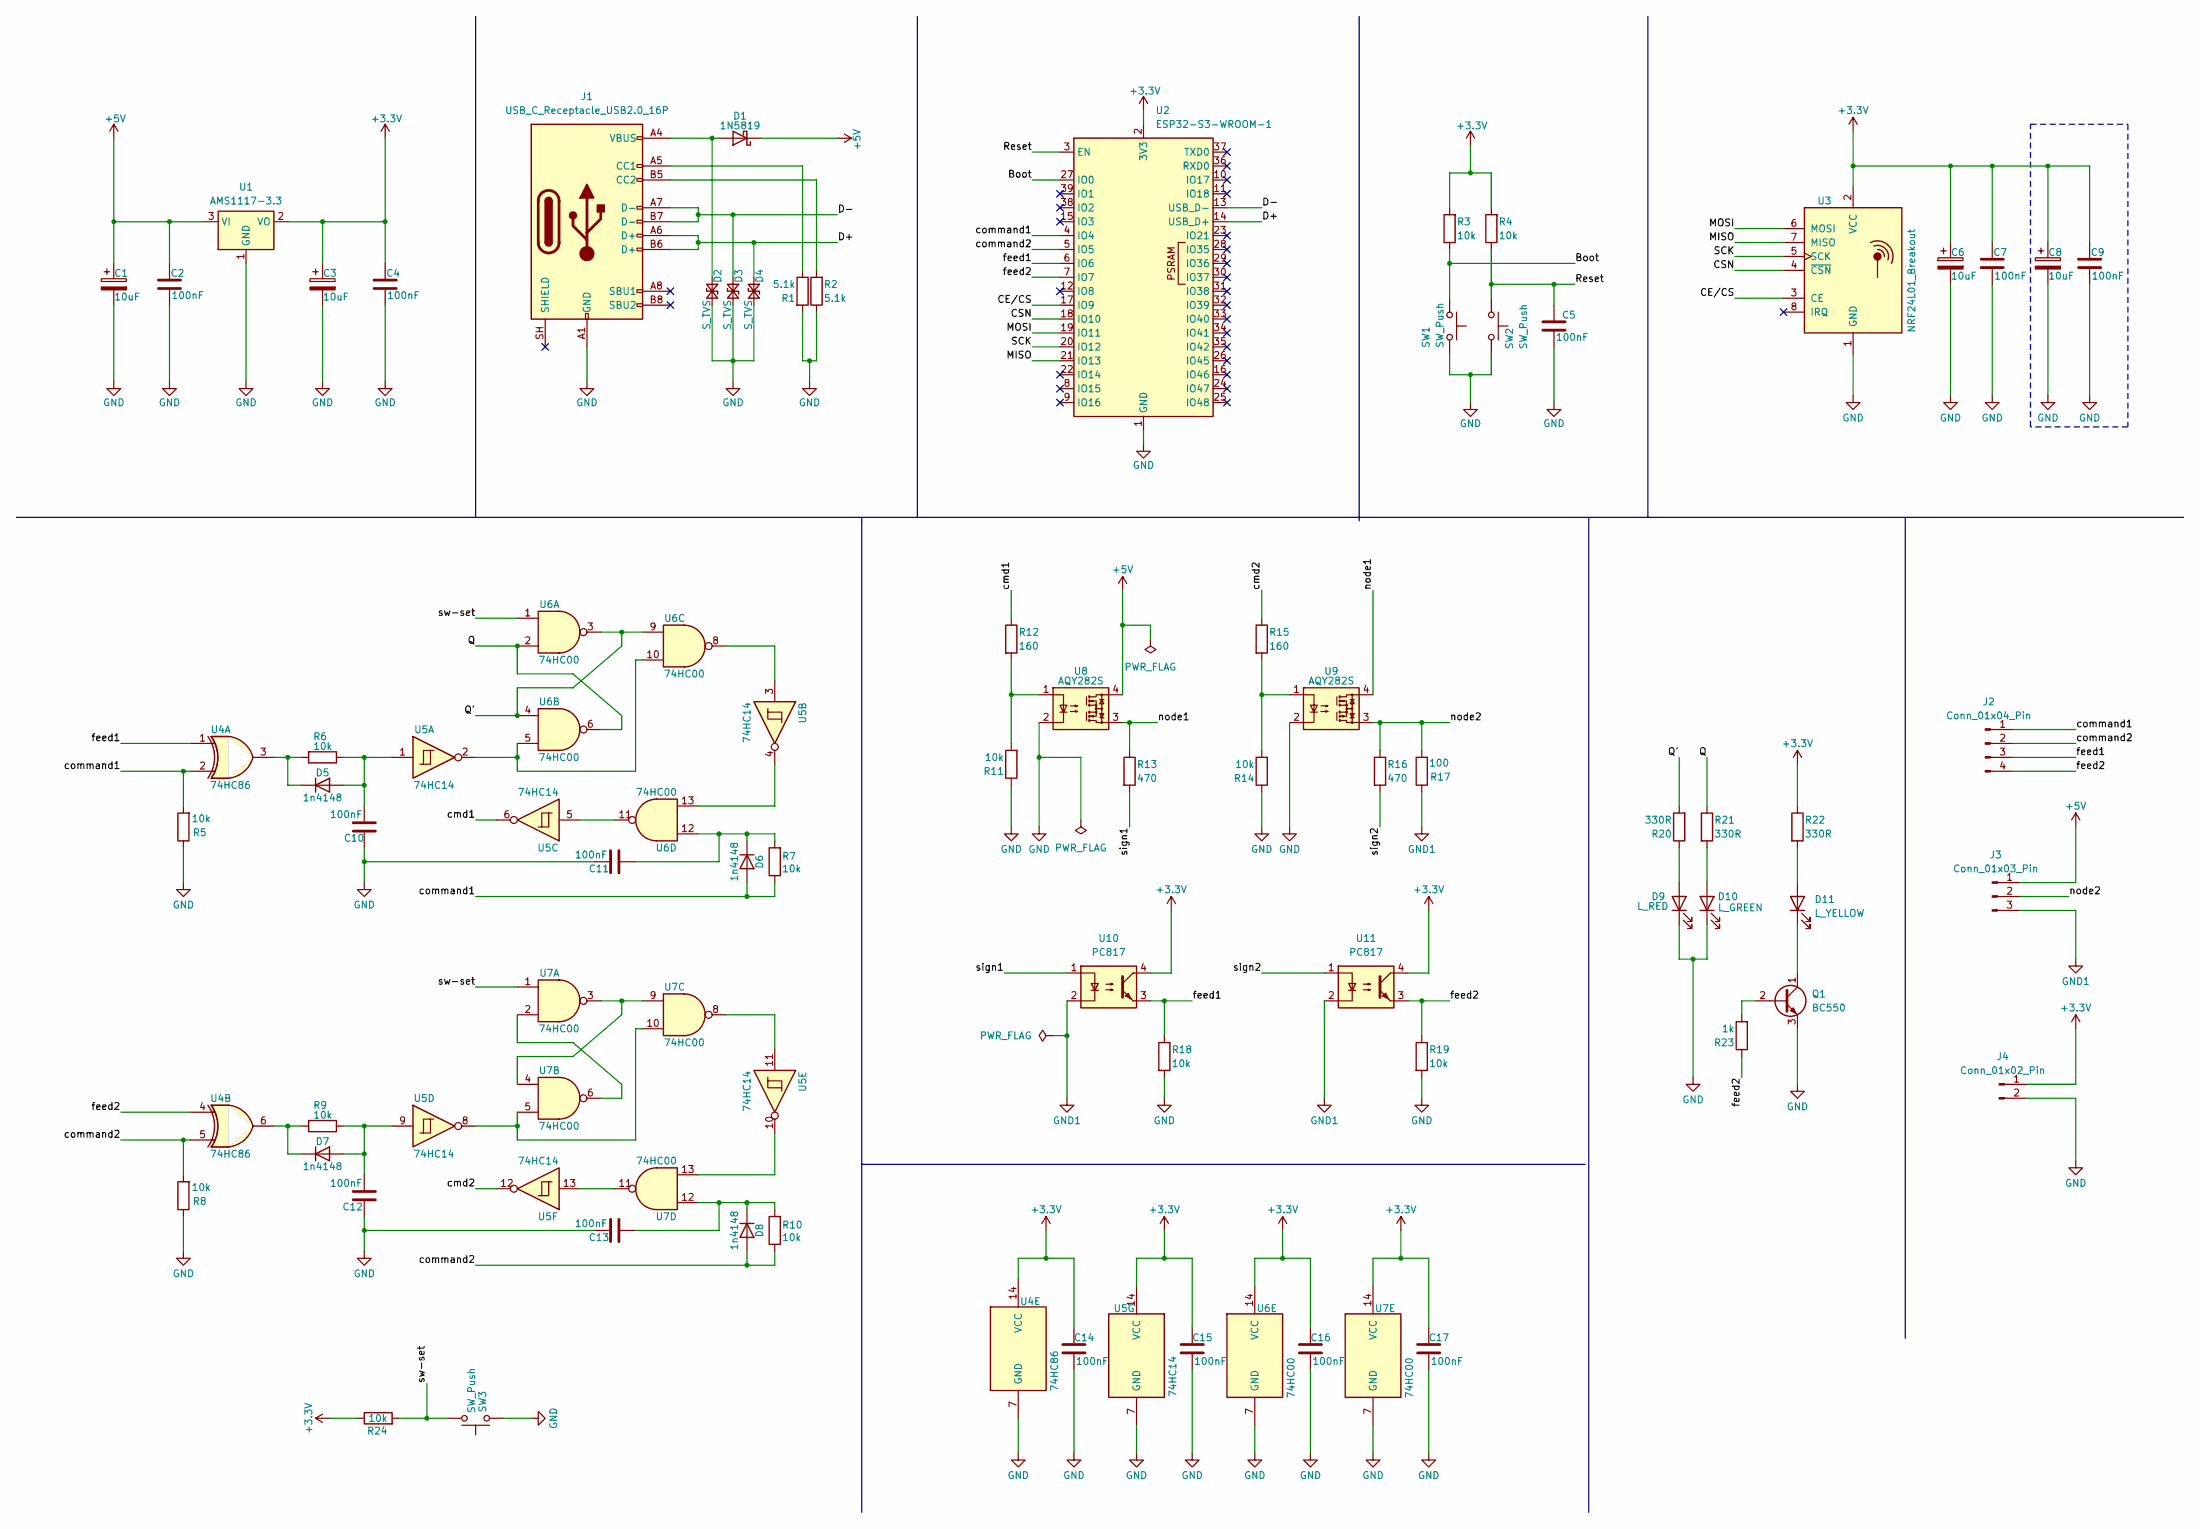
[picture p1: schematic Rx_Board-Copy.kicad_sch, Rx_Board_Wireles_Estop]

Parts:
C1, C3, C6, C8: 10uF; C_0805_2012Metric
C2, C4, C5, C7, C9, C10, C11, C12, C13, C14, C15, C16, C17: 100nF; C_0805_2012Metric
D1: 1N5819; D_SOD-123
D2, D3, D4: S_TVS; D_SOD-323
D5, D6, D7, D8: 1n4148; D_0805_2012Metric
D9: L_RED; LED_0805_2012Metric
D10: L_GREEN; LED_0805_2012Metric
D11: L_YELLOW; LED_0805_2012Metric
J1: USB_C_Receptacle_USB2.0_16P; USB_C_Receptacle_HRO_TYPE-C-31-M-12
J2: Conn_01x04_Pin; JST_EH_B4B-EH-A_1x04_P2.50mm_Vertical
J3: Conn_01x03_Pin; TerminalBlock_Phoenix_MKDS-1,5-3-5.08_1x03_P5.08mm_Horizont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
J4: Conn_01x02_Pin; JST_EH_S2B-EH_1x02_P2.50mm_Horizontal
Q1: BC550; TO-92_Inline
R1, R2: 5.1k; R_0805_2012Metric
R3, R4, R5, R6, R7, R8, R9, R10, R11, R14, R18, R19, R24: 10k; R_0805_2012Metric
R12, R15: 160; R_0805_2012Metric
R13, R16: 470; R_0805_2012Metric
R17: 100; R_0805_2012Metric
R20, R21, R22: 330R; R_0805_2012Metric
R23: 1k; R_0805_2012Metric
SW1, SW2: SW_Push; SW_Push_SPST_NO_Alps_SKRK
SW3: SW_Push; SW_Push_1P1T_NO_CK_KMR2
U1: AMS1117-3.3; SOT-223-3_TabPin2
U2: ESP32-S3-WROOM-1
U3: NRF24L01_Breakout; nRF24L01_Breakout
U4: 74HC86; SOIC-14_3.9x8.7mm_P1.27mm
U5: 74HC14; SOIC-14_3.9x8.7mm_P1.27mm
U6, U7: 74HC00; SOIC-14_3.9x8.7mm_P1.27mm
U8, U9: AQY282S; SO-4_4.4x4.3mm_P2.54mm
U10, U11: PC817; DIP-4_W7.62mm

Connections:
+3.3V: C3.1, C4.2, C6.1, C7.2, C8.1, C9.2, C14.2, C15.2, C16.2, C17.2, J4.1, R3.2, R4.2, R22.1, R24.1, U1.2 (VO), U2.2 (3V3), U3.2 (VCC), U4.14 (VCC), U5.14 (VCC), U6.14 (VCC), U7.14 (VCC), U10.4, U11.4
+5V: C1.1, C2.2, D1.1 (K), J3.1, U1.3 (VI), U8.4
/Boot: R3.1, SW1.1, U2.27 (IO0)
/CE/CS: U2.17 (IO9), U3.3 (CE)
/CSN: U2.18 (IO10), U3.4 (~CSN)
/D+: D4.1 (A1), J1.A6 (D+), J1.B6 (D+), U2.14 (USB_D+)
/D-: D3.1 (A1), J1.A7 (D-), J1.B7 (D-), U2.13 (USB_D-)
/MISO: U2.21 (IO13), U3.7 (MISO)
/MOSI: U2.19 (IO11), U3.6 (MOSI)
/Q: R21.1, U6.2, U6.6
/Q': R20.2, U6.3, U6.4, U6.9
/Reset: C5.2, R4.1, SW2.1, U2.3 (EN)
/SCK: U2.20 (IO12), U3.5 (SCK)
/cmd1: R12.1, U5.6
/cmd2: R15.1, U5.12
/command1: D6.2 (A), J2.1, R5.2, R7.1, U2.4 (IO4), U4.2
/command2: D8.2 (A), J2.2, R8.2, R10.1, U2.5 (IO5), U4.5
/feed1: J2.3, R18.1, U2.6 (IO6), U4.1, U10.3
/feed2: J2.4, R19.1, R23.1, U2.7 (IO7), U4.4, U11.3
/node1: R13.1, U8.3, U9.4
/node2: J3.2, R16.1, R17.2, U9.3
/sign1: R13.2, U10.1
/sign2: R16.2, U11.1
/sw-set: R24.2, SW3.2, U6.1, U7.1
GND: C1.2, C2.1, C3.2, C4.1, C5.1, C6.2, C7.1, C8.2, C9.1, C10.2, C11.2, C12.2, C13.2, C14.1, C15.1, C16.1, C17.1, D2.2 (A2), D3.2 (A2), D4.2 (A2), D9.1 (K), D10.1 (K), J1.A1 (GND), J1.A12 (GND), J1.B1 (GND), J1.B12 (GND), J4.2, Q1.3 (E), R1.2, R2.1, R5.1, R8.1, R11.1, R14.1, R18.2, R19.2, SW1.2, SW2.2, SW3.1, U1.1 (GND), U2.1 (GND), U2.40 (GND), U2.41 (GND), U3.1 (GND), U4.7 (GND), U5.7 (GND), U6.7 (GND), U7.7 (GND), U8.2, U9.2
GND1: J3.3, R17.1, U10.2, U11.2
unnamed: D1.2 (A), D2.1 (A1), J1.A4 (VBUS), J1.A9 (VBUS), J1.B4 (VBUS), J1.B9 (VBUS)
unnamed: C10.1, D5.2 (A), R6.1, U5.1
unnamed: D5.1 (K), R6.2, U4.3
unnamed: C11.1, D6.1 (K), R7.2, U6.12
unnamed: C12.1, D7.2 (A), R9.1, U5.9
unnamed: D7.1 (K), R9.2, U4.6
unnamed: C13.1, D8.1 (K), R10.2, U7.12
unnamed: D9.2 (A), R20.1
unnamed: D10.2 (A), R21.2
unnamed: D11.2 (A), R22.2
unnamed: D11.1 (K), Q1.1 (C)
unnamed: J1.A5 (CC1), R1.1
unnamed: J1.B5 (CC2), R2.2
unnamed: Q1.2 (B), R23.2
unnamed: R11.2, R12.2, U8.1
unnamed: R14.2, R15.2, U9.1
unnamed: U5.2, U6.5, U6.10
unnamed: U5.3, U6.8
unnamed: U5.4, U6.13
unnamed: U5.5, U6.11
unnamed: U5.8, U7.5, U7.10
unnamed: U5.10, U7.13
unnamed: U5.11, U7.8
unnamed: U5.13, U7.11
unnamed: U7.2, U7.6
unnamed: U7.3, U7.4, U7.9

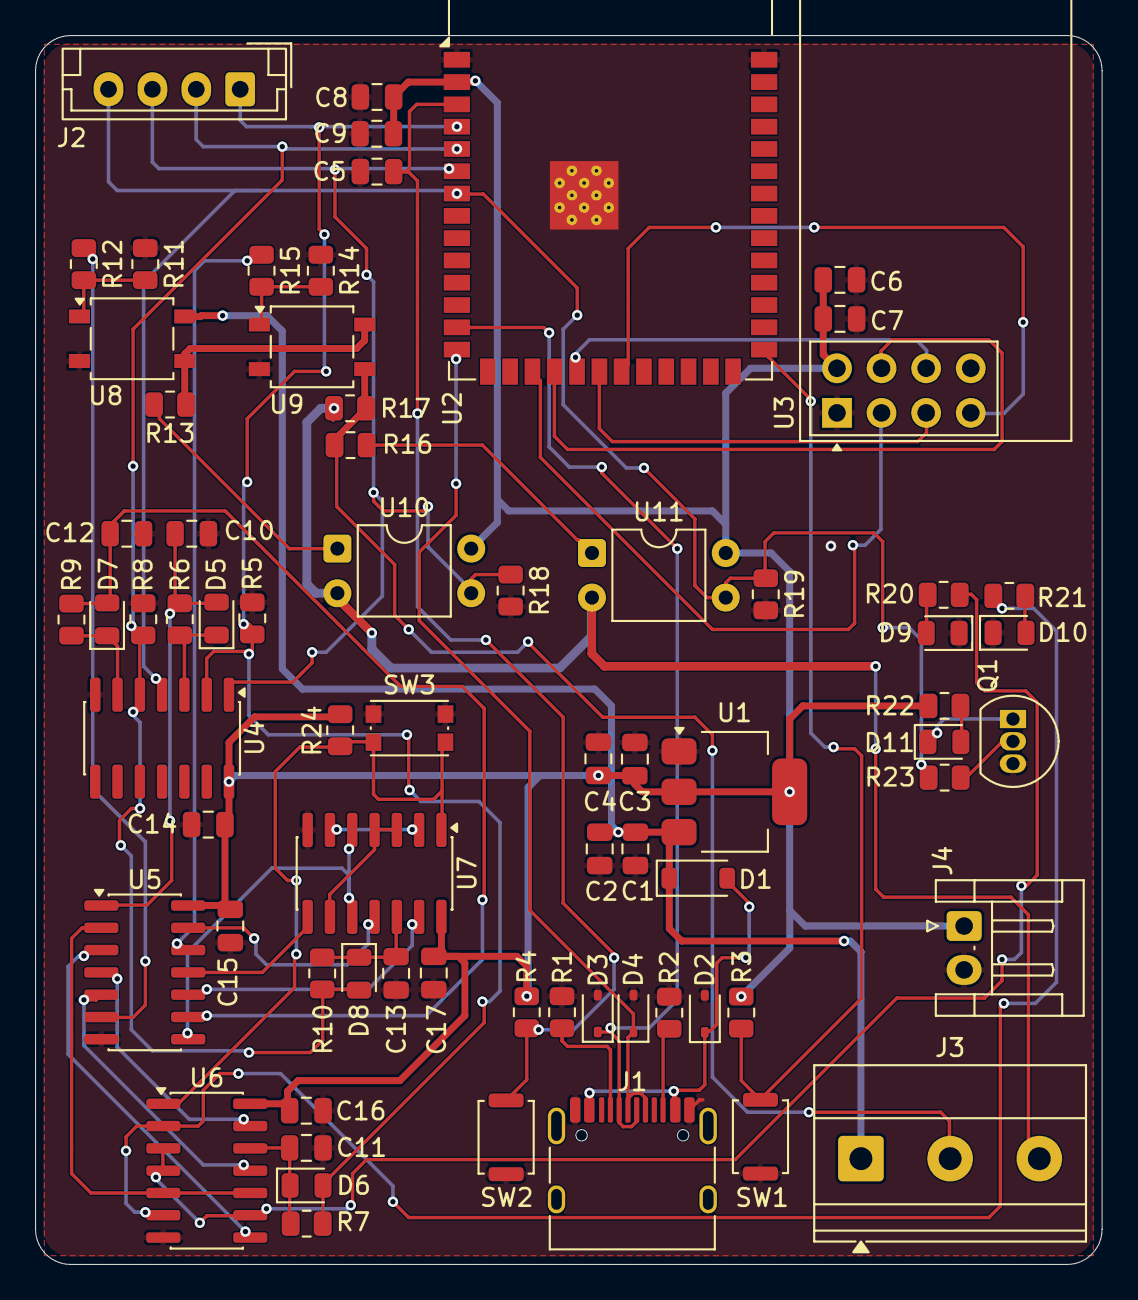
[picture p2: board Rx_Board-Copy.kicad_pcb from above]

Board: 2 copper layers, 60.8 x 70.0 mm, 71 parts (0 on the bottom side), 52 nets.
