hafizuddinus/Tx-and-Rx-Board-W-Estop/Tx-Board-Copy.kicad_pcb

## KiCad design Tx-Board-Copy.kicad_pcb (2026-10-25)

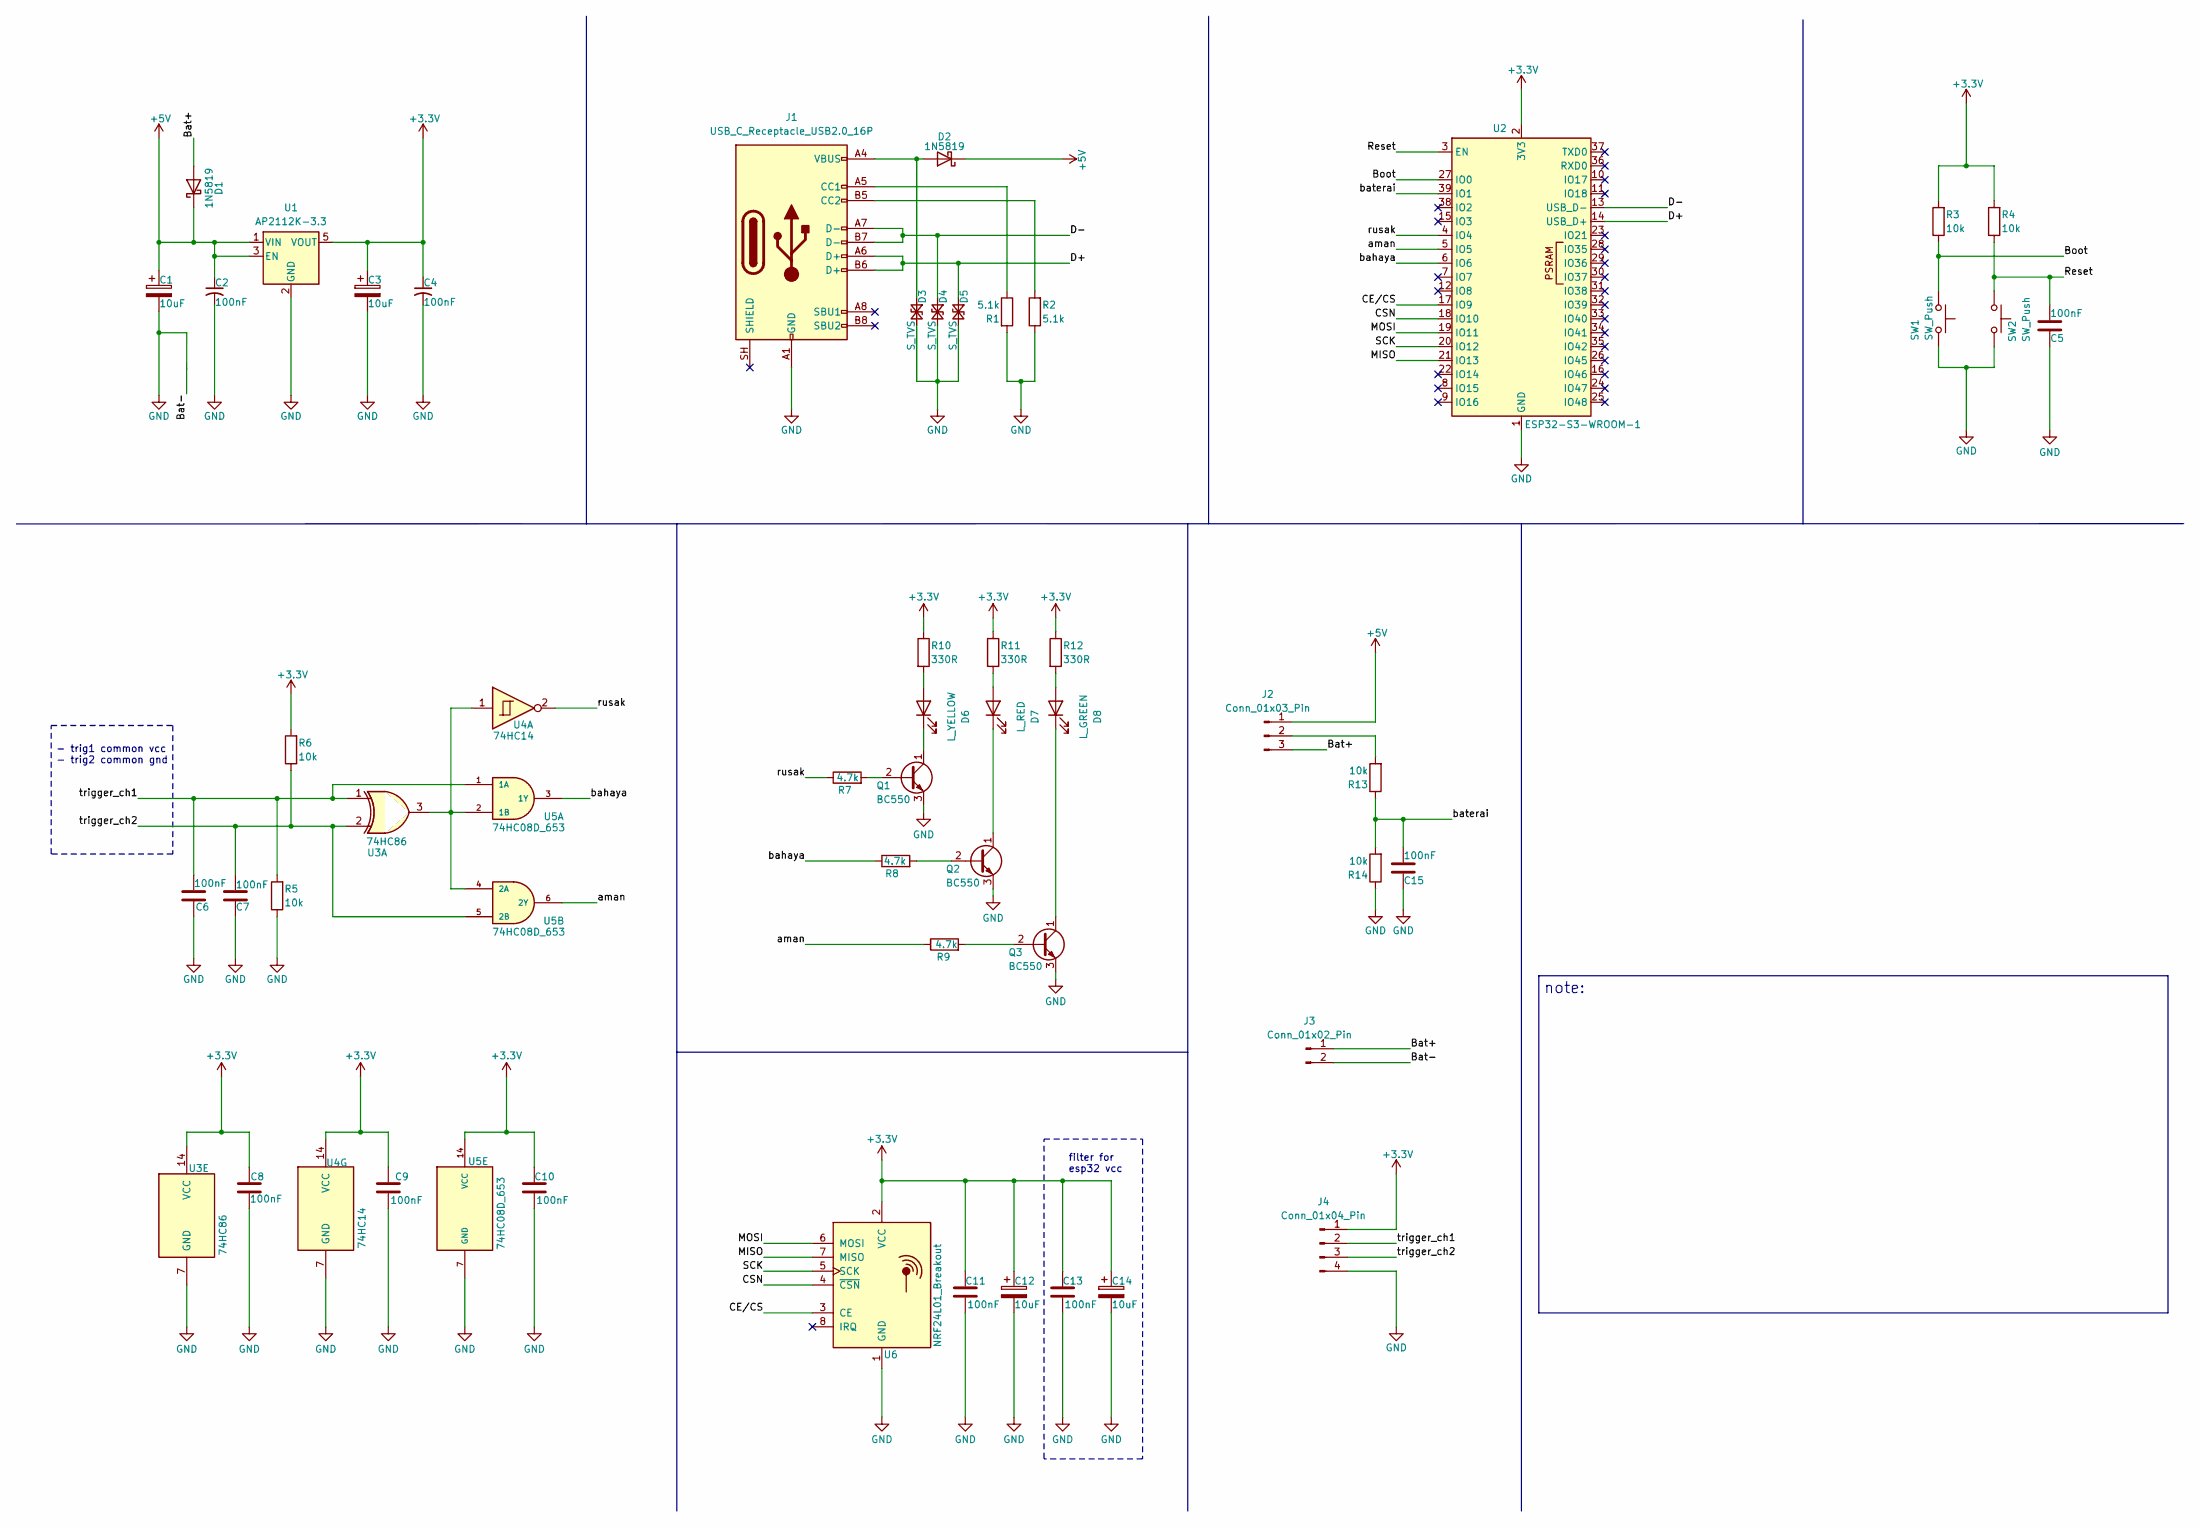
[picture p3: schematic Tx-Board.kicad_sch]

Parts:
C1, C3, C12, C14: 10uF; C_0805_2012Metric
C2, C4, C5, C6, C7, C8, C9, C10, C11, C13, C15: 100nF; C_0805_2012Metric
D1, D2: 1N5819; D_SOD-123
D3, D4, D5: S_TVS; D_SOD-323
D6: L_YELLOW; LED_0805_2012Metric
D7: L_RED; LED_0805_2012Metric
D8: L_GREEN; LED_0805_2012Metric
J1: USB_C_Receptacle_USB2.0_16P; USB_C_Receptacle_HRO_TYPE-C-31-M-12
J2: Conn_01x03_Pin; PinHeader_1x03_P2.54mm_Vertical
J3: Conn_01x02_Pin; JST_EH_B2B-EH-A_1x02_P2.50mm_Vertical
J4: Conn_01x04_Pin; JST_EH_B4B-EH-A_1x04_P2.50mm_Vertical
Q1, Q2, Q3: BC550; TO-92_Inline
R1, R2: 5.1k; R_0805_2012Metric
R3, R4, R5, R6, R13, R14: 10k; R_0805_2012Metric
R7, R8, R9: 4.7k; R_0805_2012Metric
R10, R11, R12: 330R; R_0805_2012Metric
SW1, SW2: SW_Push; SW_Push_SPST_NO_Alps_SKRK
U1: AP2112K-3.3; SOT-23-5
U2: ESP32-S3-WROOM-1
U3: 74HC86; SOIC-14_3.9x8.7mm_P1.27mm
U4: 74HC14; SOIC-14_3.9x8.7mm_P1.27mm
U5: 74HC08D_653; SOIC-14_3.9x8.7mm_P1.27mm; MPN 74HC08D,653
U6: NRF24L01_Breakout; nRF24L01_Breakout

Connections:
+3.3V: C3.1, C4.1, C8.2, C9.2, C10.2, C11.2, C12.1, C13.2, C14.1, J4.1, R3.2, R4.2, R6.2, R10.1, R11.1, R12.1, U1.5 (VOUT), U2.2 (3V3), U3.14 (VCC), U4.14 (VCC), U5.14 (VCC), U6.2 (VCC)
+5V: C1.1, C2.1, D1.1 (K), D2.1 (K), J2.1, U1.1 (VIN), U1.3 (EN)
/Bat+: D1.2 (A), J2.3, J3.1
/Boot: R3.1, SW1.1, U2.27 (IO0)
/CE/CS: U2.17 (IO9), U6.3 (CE)
/CSN: U2.18 (IO10), U6.4 (~CSN)
/D+: D5.1 (A1), J1.A6 (D+), J1.B6 (D+), U2.14 (USB_D+)
/D-: D4.1 (A1), J1.A7 (D-), J1.B7 (D-), U2.13 (USB_D-)
/MISO: U2.21 (IO13), U6.7 (MISO)
/MOSI: U2.19 (IO11), U6.6 (MOSI)
/Reset: C5.1, R4.1, SW2.1, U2.3 (EN)
/SCK: U2.20 (IO12), U6.5 (SCK)
/aman: R9.1, U2.5 (IO5), U5.6 (2Y)
/bahaya: R8.1, U2.6 (IO6), U5.3 (1Y)
/baterai: C15.1, R13.1, R14.2, U2.39 (IO1)
/rusak: R7.1, U2.4 (IO4), U4.2
/trigger_ch1: C6.1, J4.2, R5.2, U3.1, U5.1 (1A)
/trigger_ch2: C7.1, J4.3, R6.1, U3.2, U5.5 (2B)
GND: C1.2, C2.2, C3.2, C4.2, C5.2, C6.2, C7.2, C8.1, C9.1, C10.1, C11.1, C12.2, C13.1, C14.2, C15.2, D3.2 (A2), D4.2 (A2), D5.2 (A2), J1.A1 (GND), J1.A12 (GND), J1.B1 (GND), J1.B12 (GND), J3.2, J4.4, Q1.3 (E), Q2.3 (E), Q3.3 (E), R1.2, R2.1, R5.1, R14.1, SW1.2, SW2.2, U1.2 (GND), U2.1 (GND), U2.40 (GND), U2.41 (GND), U3.7 (GND), U4.7 (GND), U5.7 (GND), U6.1 (GND)
unnamed: D2.2 (A), D3.1 (A1), J1.A4 (VBUS), J1.A9 (VBUS), J1.B4 (VBUS), J1.B9 (VBUS)
unnamed: D6.2 (A), R10.2
unnamed: D6.1 (K), Q1.1 (C)
unnamed: D7.2 (A), R11.2
unnamed: D7.1 (K), Q2.1 (C)
unnamed: D8.2 (A), R12.2
unnamed: D8.1 (K), Q3.1 (C)
unnamed: J1.A5 (CC1), R1.1
unnamed: J1.B5 (CC2), R2.2
unnamed: J2.2, R13.2
unnamed: Q1.2 (B), R7.2
unnamed: Q2.2 (B), R8.2
unnamed: Q3.2 (B), R9.2
unnamed: U3.3, U4.1, U5.2 (1B), U5.4 (2A)

Notes on the sheet:
filter for esp32 vcc
note:
- trig1 common vcc - trig2 common gnd

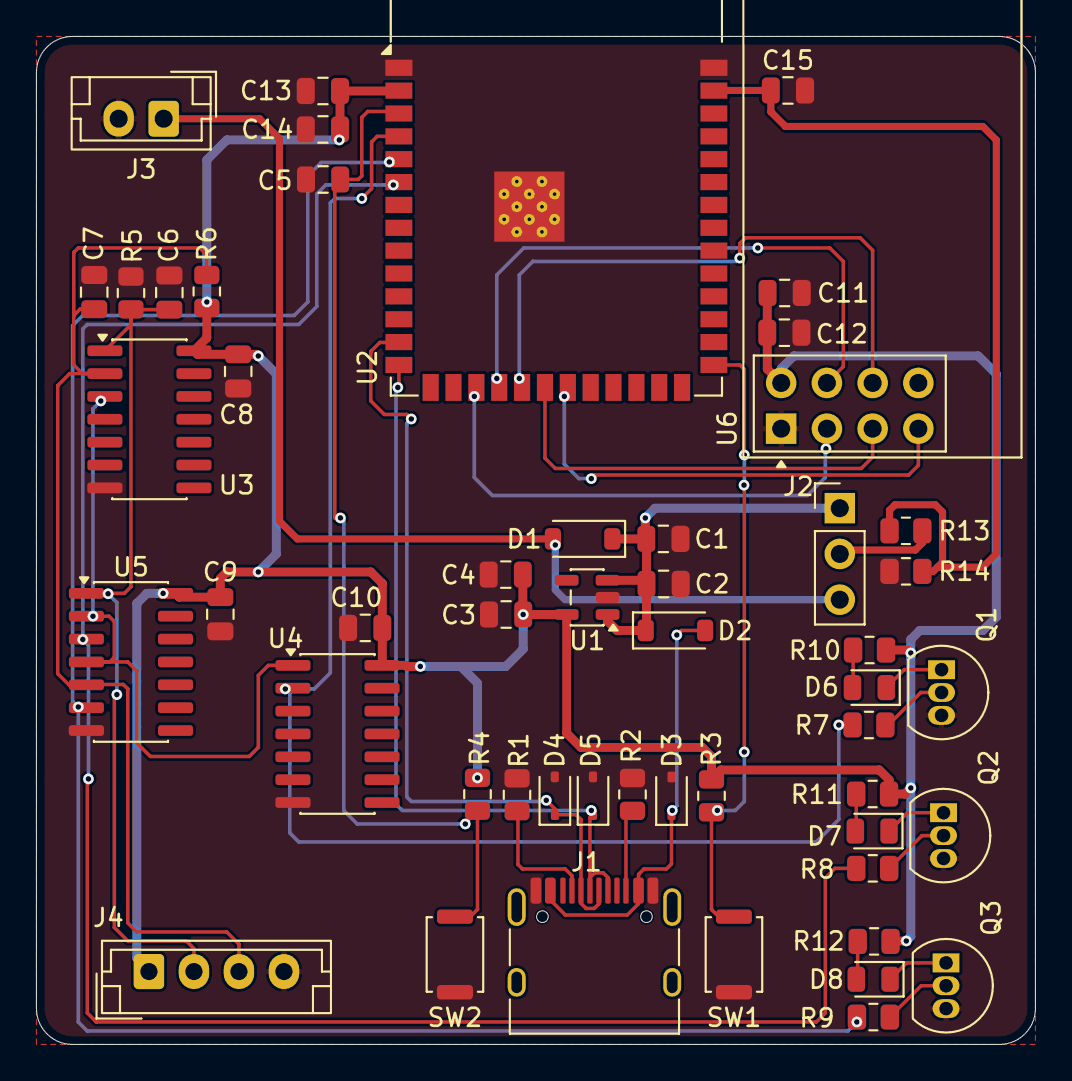
[picture p4: board Tx-Board-Copy.kicad_pcb from above]

Board: 2 copper layers, 55.5 x 56.0 mm, 52 parts (0 on the bottom side), 33 nets.
