hafizuddinus/Tx-and-Rx-Board-W-Estop/(commit log)

2026-10-25 Add schematic and layout links to README
    Added links to schematic and layout for tx and rx boards.
2026-10-29 Document FMEA and safety analysis for Wireless E-Stop
    Add comprehensive FMEA analysis and safety architecture for Wireless E-Stop system, including TX and RX board evaluations, diagnostic coverage calculations, and fault injection test procedures.
2026-10-29 Update diode connection in failure analysis table
